kvnen/LVDCDC/LV_DCDC.kicad_pcb

## KiCad design LV_DCDC.kicad_pcb (2026-04-30)

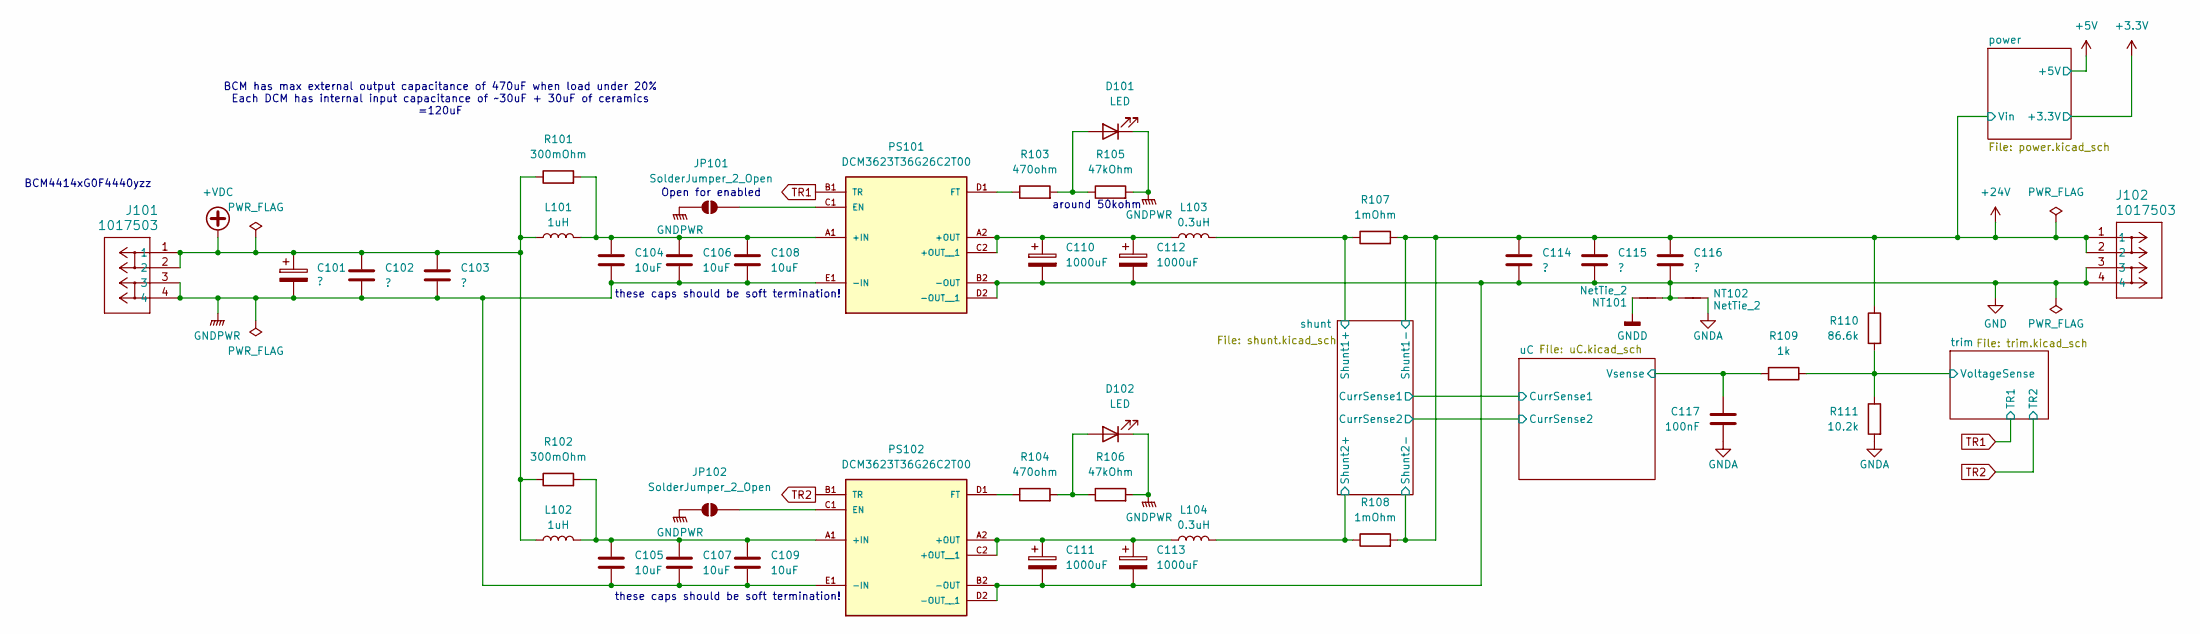
[picture p1: schematic LV_DCDC.kicad_sch]

Parts:
C101: ?; CP_Radial_D12.5mm_P5.00mm
C102, C103, C114, C115, C116: ?; C_1206_3216Metric
C104, C105, C106, C107, C108, C109: 10uF; C_1206_3216Metric
C110, C111, C112, C113: 1000uF; CP_Radial_D12.5mm_P5.00mm
C117: 100nF; C_0603_1608Metric
D101, D102: LED; LED_0603_1608Metric
J101, J102: 1017503; CONN_1017491
JP101, JP102: SolderJumper_2_Open; SolderJumper-2_P1.3mm_Open_TrianglePad1.0x1.5mm
L101, L102: 1uH; L_Bourns_SRP1770TA_16.9x16.9mm
L103, L104: 0.3uH; L_APV_APH1040
NT101, NT102: NetTie_2; NetTie-2_SMD_Pad2.0mm
PS101, PS102: DCM3623T36G26C2T00; CONV_DCM3623T36G26C2T00; PARTREV 1.2
R101, R102: 300mOhm; R_1206_3216Metric
R103, R104: 470ohm; R_0603_1608Metric
R105, R106: 47kOhm; R_0603_1608Metric
R107, R108: 1mOhm; R_2512_6332Metric
R109: 1k; R_0603_1608Metric
R110: 86.6k; R_0603_1608Metric
R111: 10.2k; R_0603_1608Metric

Connections:
+24V: C114.1, C115.1, C116.1, J102.1, J102.2, R107.2, R108.2, R110.1; also elsewhere on the board
+VDC: C101.1, C102.1, C103.1, J101.1, J101.2, L101.1, L102.1, R101.1, R102.1
/shunt/Shunt1+: L103.2, R107.1; also elsewhere on the board
/shunt/Shunt2+: L104.2, R108.1; also elsewhere on the board
/trim/VoltageSense: R109.1, R110.2, R111.1; also elsewhere on the board
/uC/Vsense: C117.1, R109.2; also elsewhere on the board
GND: C110.2, C111.2, C112.2, C113.2, C114.2, C115.2, C116.2, J102.3, J102.4, NT101.2, NT102.2, PS101.B2 (-OUT), PS101.D2 (-OUT__1), PS102.B2 (-OUT), PS102.D2 (-OUT__1)
GNDA: C117.2, NT102.1, R111.2; also elsewhere on the board
GNDD: NT101.1; also elsewhere on the board
GNDPWR: C101.2, C102.2, C103.2, C104.2, C105.2, C106.2, C107.2, C108.2, C109.2, D101.1 (K), D102.1 (K), J101.3, J101.4, JP101.2 (B), JP102.2 (B), PS101.E1 (-IN), PS102.E1 (-IN), R105.2, R106.2; also elsewhere on the board
unnamed: D101.2 (A), R103.2, R105.1
unnamed: D102.2 (A), R104.2, R106.1
unnamed: JP101.1 (A), PS101.C1 (EN)
unnamed: JP102.1 (A), PS102.C1 (EN)
unnamed: C104.1, C106.1, C108.1, L101.2, PS101.A1 (+IN), R101.2
unnamed: C110.1, C112.1, L103.1, PS101.A2 (+OUT), PS101.C2 (+OUT__1)
unnamed: PS101.D1 (FT), R103.1
unnamed: C105.1, C107.1, C109.1, L102.2, PS102.A1 (+IN), R102.2
unnamed: C111.1, C113.1, L104.1, PS102.A2 (+OUT), PS102.C2 (+OUT__1)
unnamed: PS102.D1 (FT), R104.1
TR1: PS101.B1 (TR); also elsewhere on the board
TR2: PS102.B1 (TR); also elsewhere on the board

Notes on the sheet:
around 50kohm
Open for enabled
these caps should be soft termination!
BCM has max external output capacitance of 470uF when load under 20% Each DCM has internal input capacitance of ~30uF + 30uF of ceramics =120uF
BCM4414xG0F4440yzz

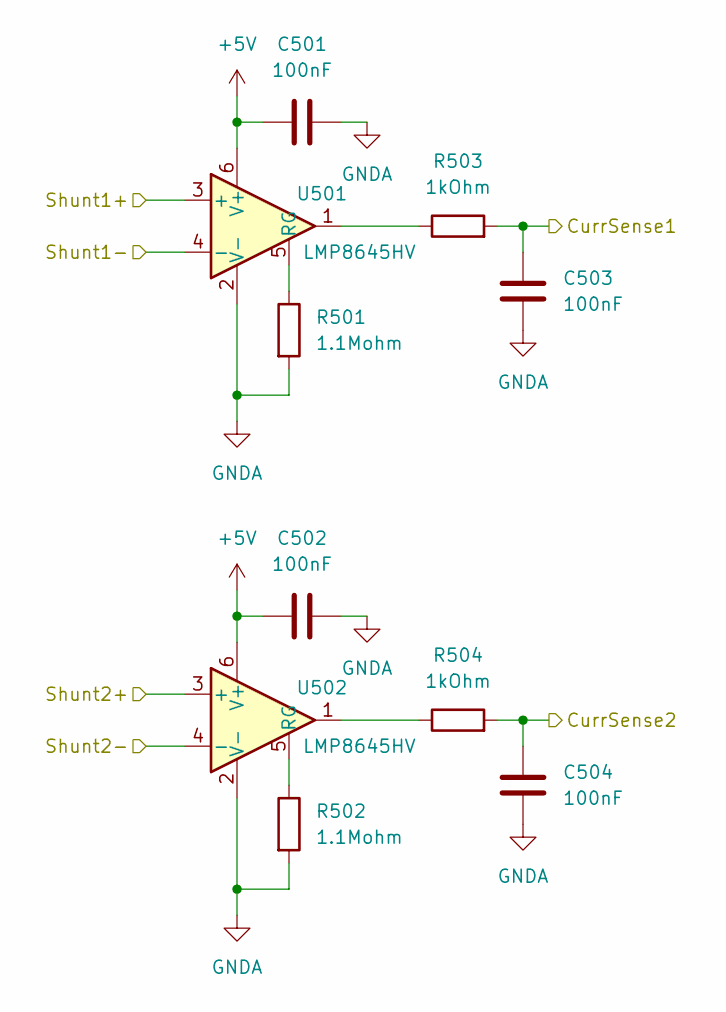
[picture p2: schematic shunt.kicad_sch]

Parts:
C501, C502, C503, C504: 100nF; C_0603_1608Metric
R501, R502: 1.1Mohm; R_0603_1608Metric
R503, R504: 1kOhm; R_0603_1608Metric
U501, U502: LMP8645HV; TSOT-23-6_HandSoldering

Connections:
+5V: C501.1, C502.1, U501.6 (V+), U502.6 (V+); also elsewhere on the board
+24V: U501.4 (-), U502.4 (-); also elsewhere on the board
/shunt/CurrSense1: C503.1, R503.2; also elsewhere on the board
/shunt/CurrSense2: C504.1, R504.2; also elsewhere on the board
/shunt/Shunt1+: U501.3 (+); also elsewhere on the board
/shunt/Shunt2+: U502.3 (+); also elsewhere on the board
GNDA: C501.2, C502.2, C503.2, C504.2, R501.2, R502.2, U501.2 (V-), U502.2 (V-); also elsewhere on the board
unnamed: R503.1, U501.1
unnamed: R504.1, U502.1
unnamed: R501.1, U501.5 (RG)
unnamed: R502.1, U502.5 (RG)

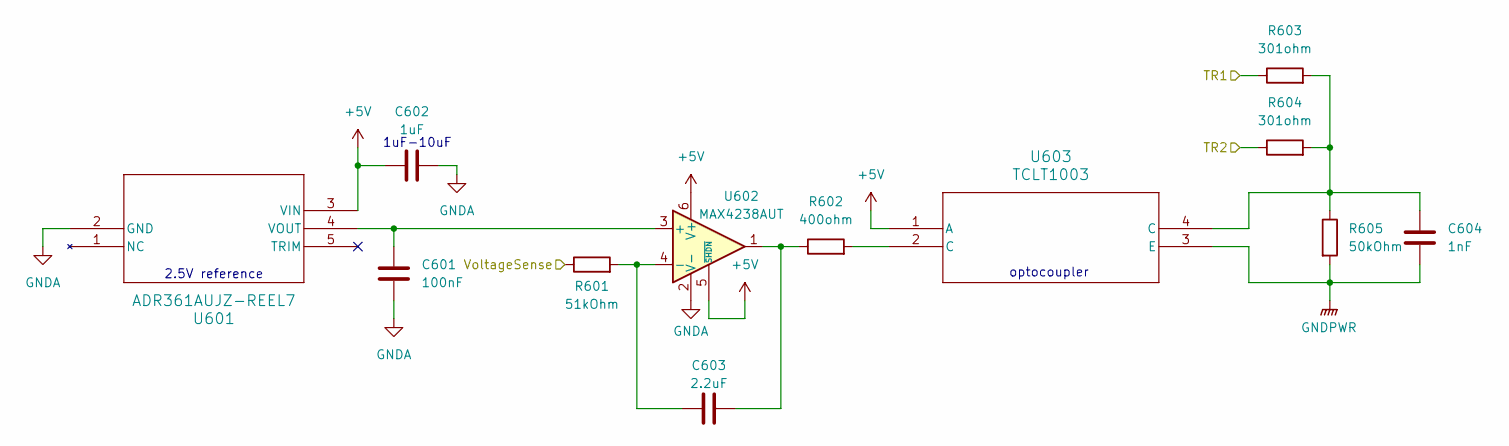
[picture p3: schematic trim.kicad_sch]

Parts:
C601: 100nF; C_0603_1608Metric
C602: 1uF; C_0603_1608Metric
C603: 2.2uF; C_0603_1608Metric
C604: 1nF; C_0603_1608Metric
R601: 51kOhm; R_0603_1608Metric
R602: 400ohm; R_0603_1608Metric
R603, R604: 301ohm; R_0603_1608Metric
R605: 50kOhm; R_0603_1608Metric
U601: ADR361AUJZ-REEL7; UJ_5_ADI
U602: MAX4238AUT; SOT-23-6
U603: TCLT1003; SOP-4L_TC

Connections:
+5V: C602.1, U601.3 (VIN), U602.5 (~SHDN), U602.6 (V+), U603.1 (A); also elsewhere on the board
/trim/VoltageSense: R601.1; also elsewhere on the board
GNDA: C601.2, C602.2, U601.2 (GND), U602.2 (V-); also elsewhere on the board
GNDPWR: C604.2, R605.2, U603.3 (E); also elsewhere on the board
unnamed: C603.2, R602.1, U602.1
unnamed: C604.1, R603.2, R604.2, R605.1, U603.4 (C)
unnamed: R602.2, U603.2 (C)
unnamed: C601.1, U601.4 (VOUT), U602.3 (+)
unnamed: C603.1, R601.2, U602.4 (-)
TR1: R603.1; also elsewhere on the board
TR2: R604.1; also elsewhere on the board

Notes on the sheet:
2.5V reference
optocoupler
1uF-10uF

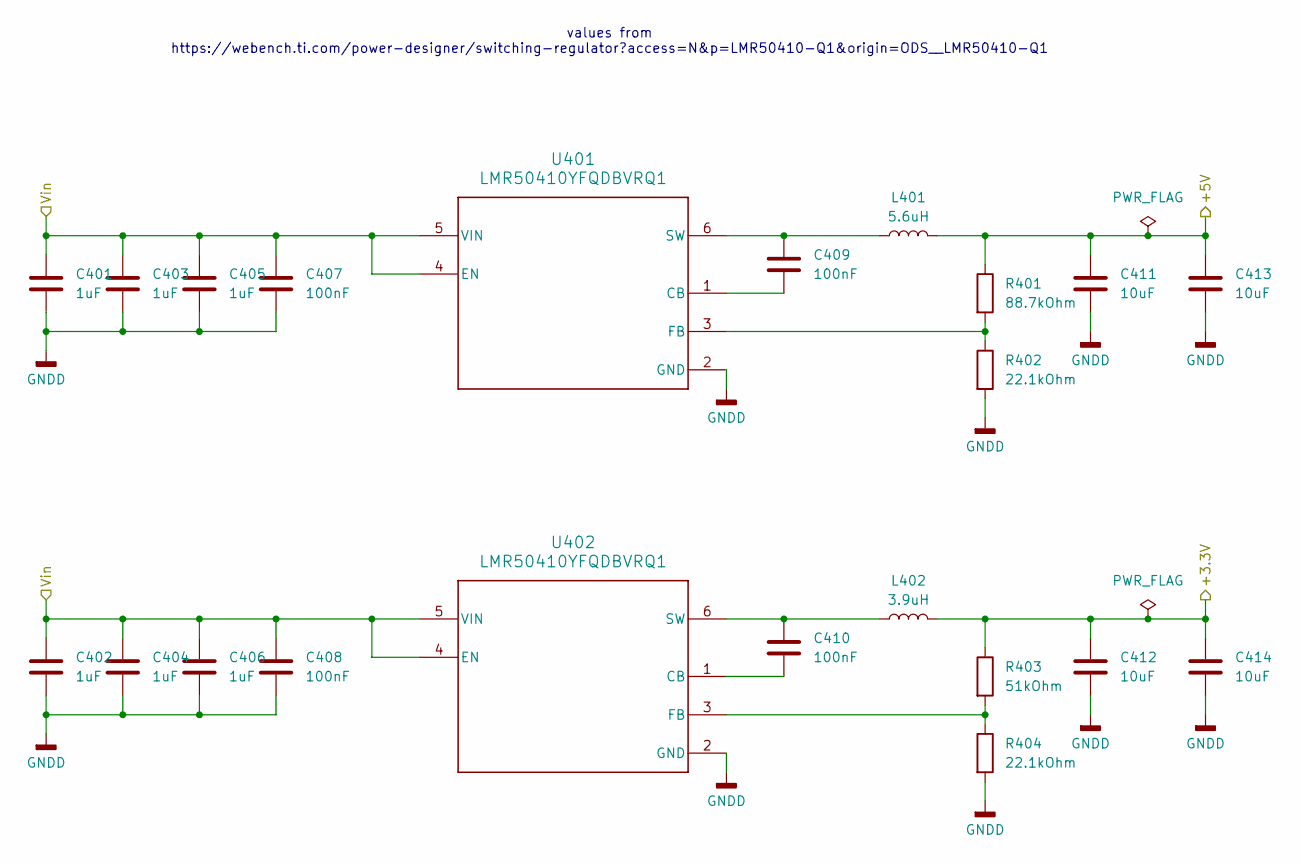
[picture p4: schematic power.kicad_sch]

Parts:
C401, C402, C403, C404, C405, C406: 1uF; C_1206_3216Metric
C407, C408, C409, C410: 100nF; C_0603_1608Metric
C411, C412, C413, C414: 10uF; C_1206_3216Metric
L401: 5.6uH; L_1812_4532Metric
L402: 3.9uH; L_1812_4532Metric
R401: 88.7kOhm; R_0603_1608Metric
R402, R404: 22.1kOhm; R_0603_1608Metric
R403: 51kOhm; R_0603_1608Metric
U401, U402: LMR50410YFQDBVRQ1; DBV0006A-IPC_A

Connections:
+3.3V: C412.1, C414.1, L402.2, R403.1; also elsewhere on the board
+5V: C411.1, C413.1, L401.2, R401.1; also elsewhere on the board
+24V: C401.1, C402.1, C403.1, C404.1, C405.1, C406.1, C407.1, C408.1, U401.4 (EN), U401.5 (VIN), U402.4 (EN), U402.5 (VIN); also elsewhere on the board
GNDD: C401.2, C402.2, C403.2, C404.2, C405.2, C406.2, C407.2, C408.2, C411.2, C412.2, C413.2, C414.2, R402.2, R404.2, U401.2 (GND), U402.2 (GND); also elsewhere on the board
unnamed: C409.2, U401.1 (CB)
unnamed: R401.2, R402.1, U401.3 (FB)
unnamed: C409.1, L401.1, U401.6 (SW)
unnamed: C410.2, U402.1 (CB)
unnamed: R403.2, R404.1, U402.3 (FB)
unnamed: C410.1, L402.1, U402.6 (SW)

Notes on the sheet:
values from https://webench.ti.com/power-designer/switching-regulator?access=N&p=LMR50410-Q1&origin=ODS__LMR50410-Q1

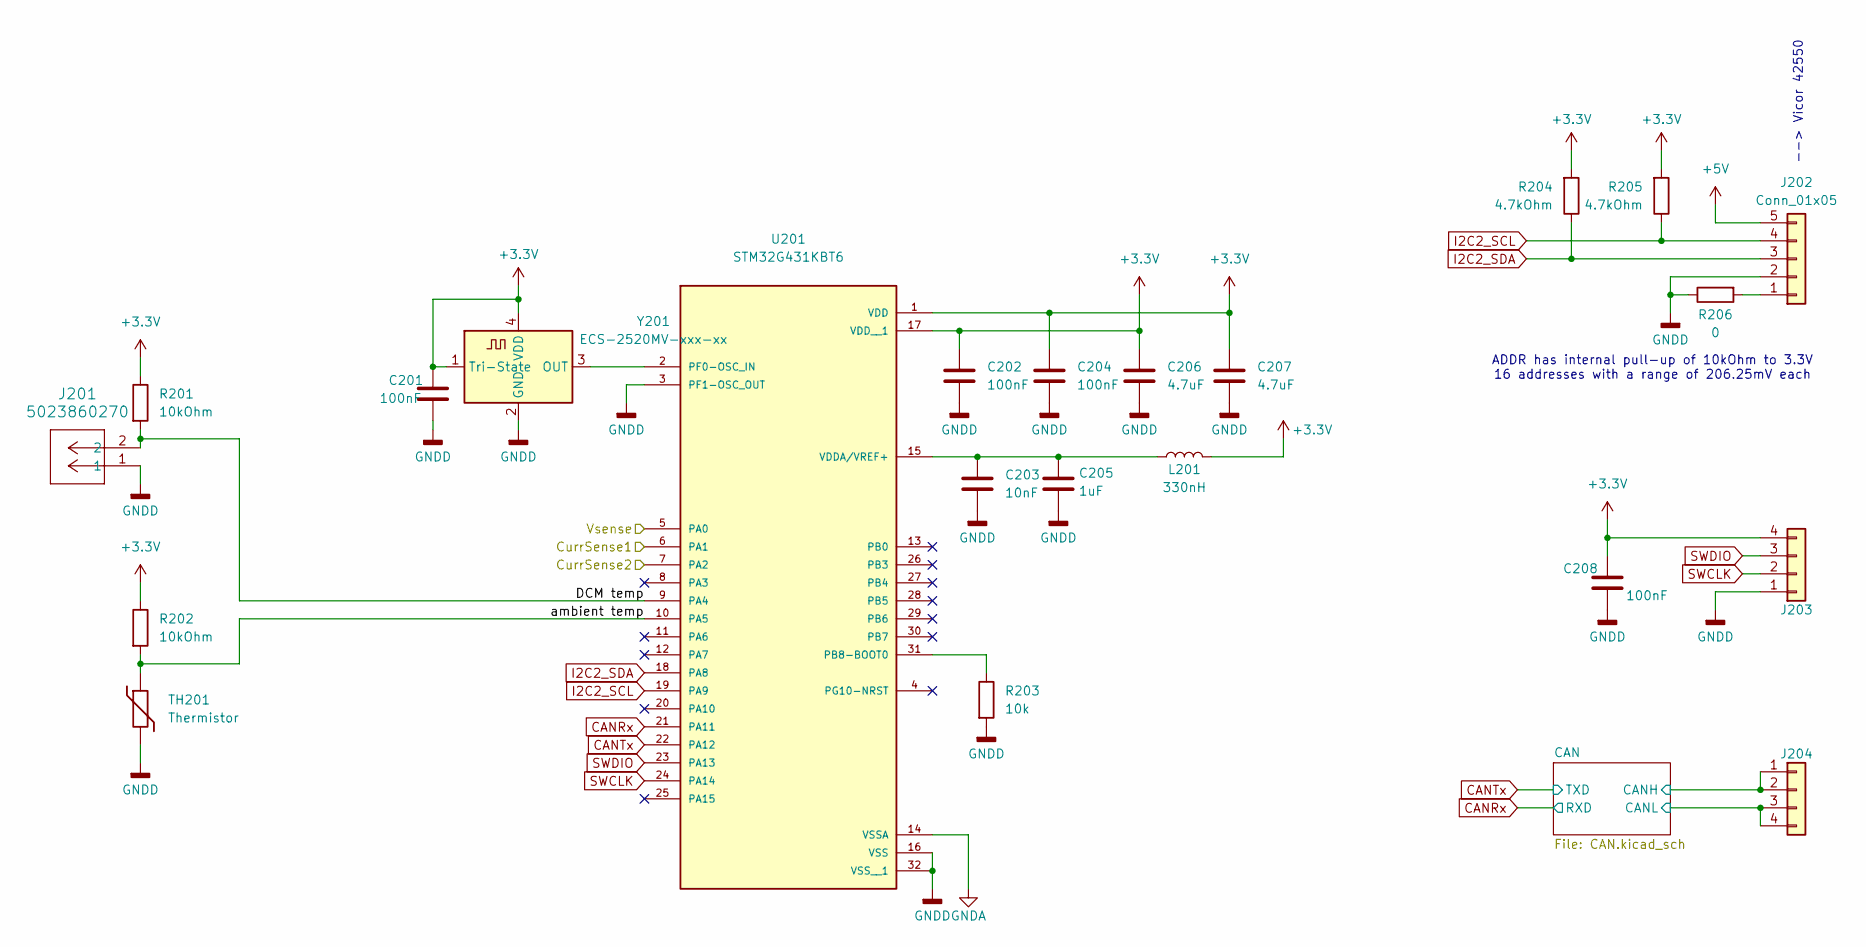
[picture p5: schematic uC.kicad_sch]

Parts:
C201, C202, C204: 100nF; C_0603_1608Metric
C203: 10nF; C_0603_1608Metric
C205: 1uF; C_0603_1608Metric
C206, C207: 4.7uF; C_0603_1608Metric
C208: 100nF; C_0805_2012Metric_Pad1.18x1.45mm_HandSolder; TOLERANCE (FILL IN AS +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 10%
J201: 5023860270; CONN_502386-02xx_MOL
J202: Conn_01x05; PinHeader_2x05_P2.54mm_Vertical
J203: Conn_01x04; PinSocket_1x04_P2.54mm_Vertical
J204: Conn_01x04; PinHeader_2x04_P2.54mm_Vertical
L201: 330nH; L_0805_2012Metric
R201, R202: 10kOhm; R_0603_1608Metric
R203: 10k; R_0603_1608Metric
R204, R205: 4.7kOhm; R_0603_1608Metric
R206: 0; R_0603_1608Metric
TH201: Thermistor; R_0805_2012Metric
U201: STM32G431KBT6; LQFP-32_7x7mm_P0.8mm; PARTREV 2
Y201: ECS-2520MV-xxx-xx; Oscillator_SMD_ECS_2520MV-xxx-xx-4Pin_2.5x2.0mm

Connections:
+3.3V: C201.1, C202.1, C204.1, C206.1, C207.1, C208.1, J203.4, L201.2, R201.1, R202.1, R204.2, R205.2, U201.1 (VDD), U201.17 (VDD__1), Y201.1 (Tri-State), Y201.4 (VDD); also elsewhere on the board
+5V: J202.5; also elsewhere on the board
/shunt/CurrSense1: U201.6 (PA1); also elsewhere on the board
/shunt/CurrSense2: U201.7 (PA2); also elsewhere on the board
/uC/CAN/CANH: J204.1, J204.2; also elsewhere on the board
/uC/CAN/CANL: J204.3, J204.4; also elsewhere on the board
/uC/DCM temp: J201.2, R201.2, U201.9 (PA4)
/uC/Vsense: U201.5 (PA0); also elsewhere on the board
/uC/ambient temp: R202.2, TH201.1, U201.10 (PA5)
CANRx: U201.21 (PA11); also elsewhere on the board
CANTx: U201.22 (PA12); also elsewhere on the board
GNDA: U201.14 (VSSA); also elsewhere on the board
GNDD: C201.2, C202.2, C203.2, C204.2, C205.2, C206.2, C207.2, C208.2, J201.1, J202.2, J203.1, R203.2, R206.1, TH201.2, U201.3 (PF1-OSC_OUT), U201.16 (VSS), U201.32 (VSS__1), Y201.2 (GND); also elsewhere on the board
I2C2_SCL: J202.4, R205.1, U201.19 (PA9)
I2C2_SDA: J202.3, R204.1, U201.18 (PA8)
unnamed: J202.1, R206.2
unnamed: R203.1, U201.31 (PB8-BOOT0)
unnamed: U201.2 (PF0-OSC_IN), Y201.3 (OUT)
unnamed: C203.1, C205.1, L201.1, U201.15 (VDDA/VREF+)
SWCLK: J203.2, U201.24 (PA14)
SWDIO: J203.3, U201.23 (PA13)

Notes on the sheet:
--> Vicor 42550
ADDR has internal pull-up of 10kOhm to 3.3V 16 addresses with a range of 206.25mV each

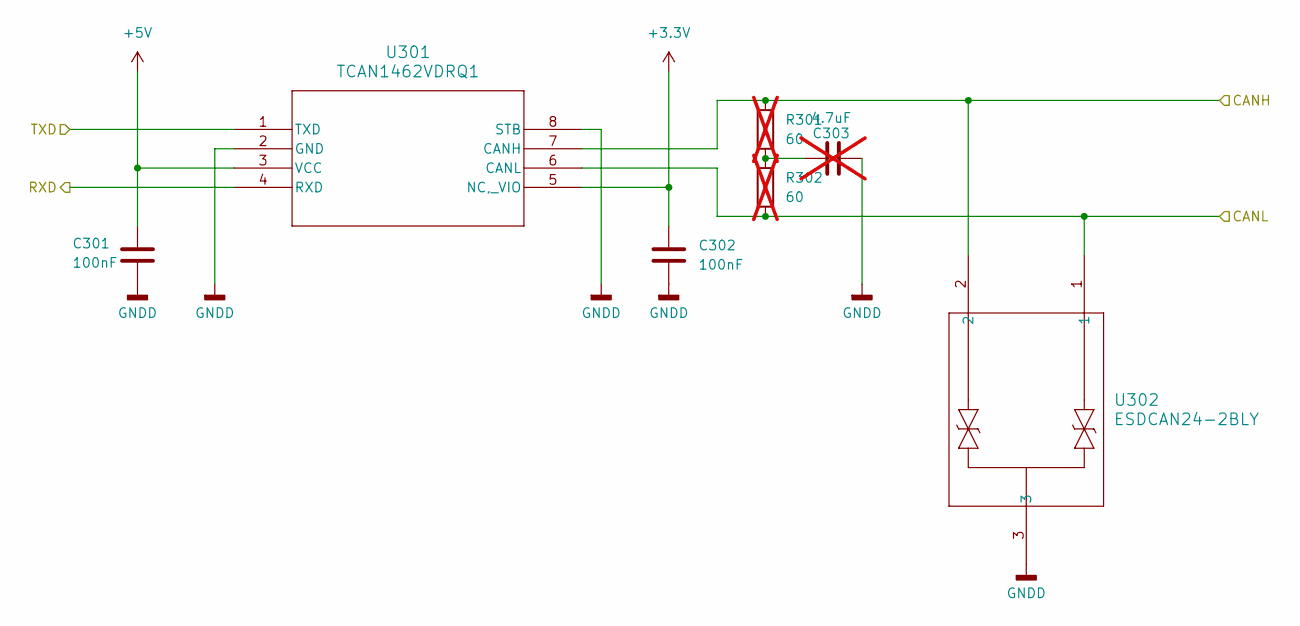
[picture p6: schematic CAN.kicad_sch]

Parts:
C301, C302: 100nF; C_0603_1608Metric
C303: 4.7uF; C_0603_1608Metric; not fitted
R301, R302: 60; R_0603_1608Metric; not fitted
U301: TCAN1462VDRQ1; SOIC8_D_TEX
U302: ESDCAN24-2BLY; SOT_24-2BLY_STM

Connections:
+3.3V: C302.1, U301.5 (NC,_VIO); also elsewhere on the board
+5V: C301.1, U301.3 (VCC); also elsewhere on the board
/uC/CAN/CANH: R301.1, U301.7 (CANH), U302.2; also elsewhere on the board
/uC/CAN/CANL: R302.2, U301.6 (CANL), U302.1; also elsewhere on the board
CANRx: U301.4 (RXD); also elsewhere on the board
CANTx: U301.1 (TXD); also elsewhere on the board
GNDD: C301.2, C302.2, C303.1, U301.2 (GND), U301.8 (STB), U302.3; also elsewhere on the board
unnamed: C303.2, R301.2, R302.1

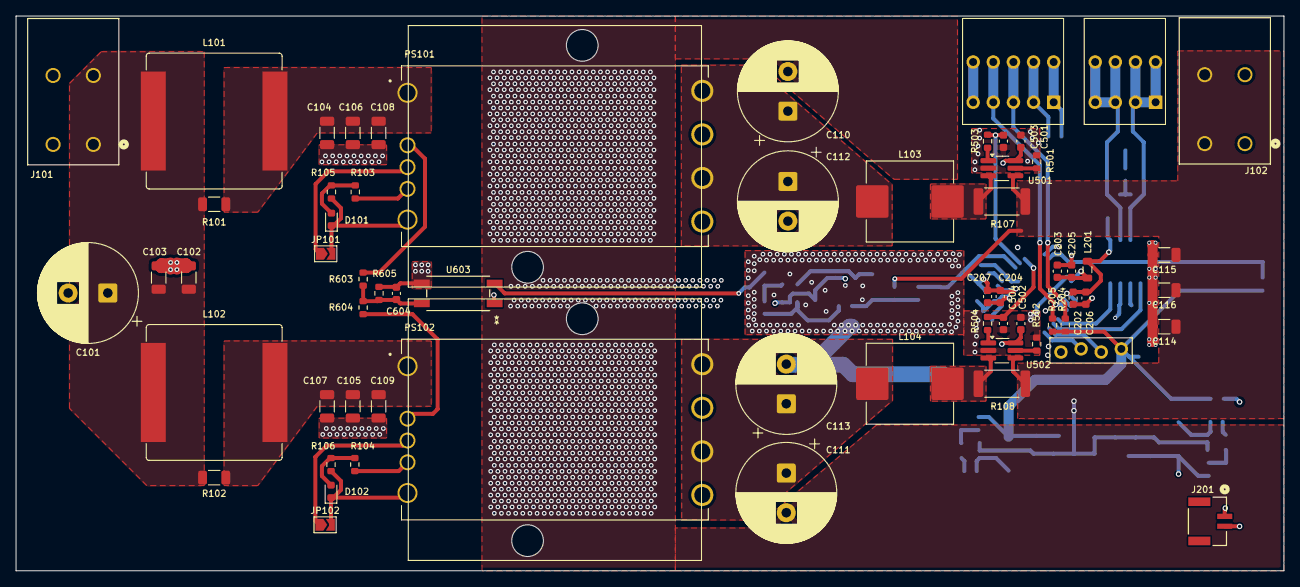
[picture p7: board LV_DCDC.kicad_pcb from above]

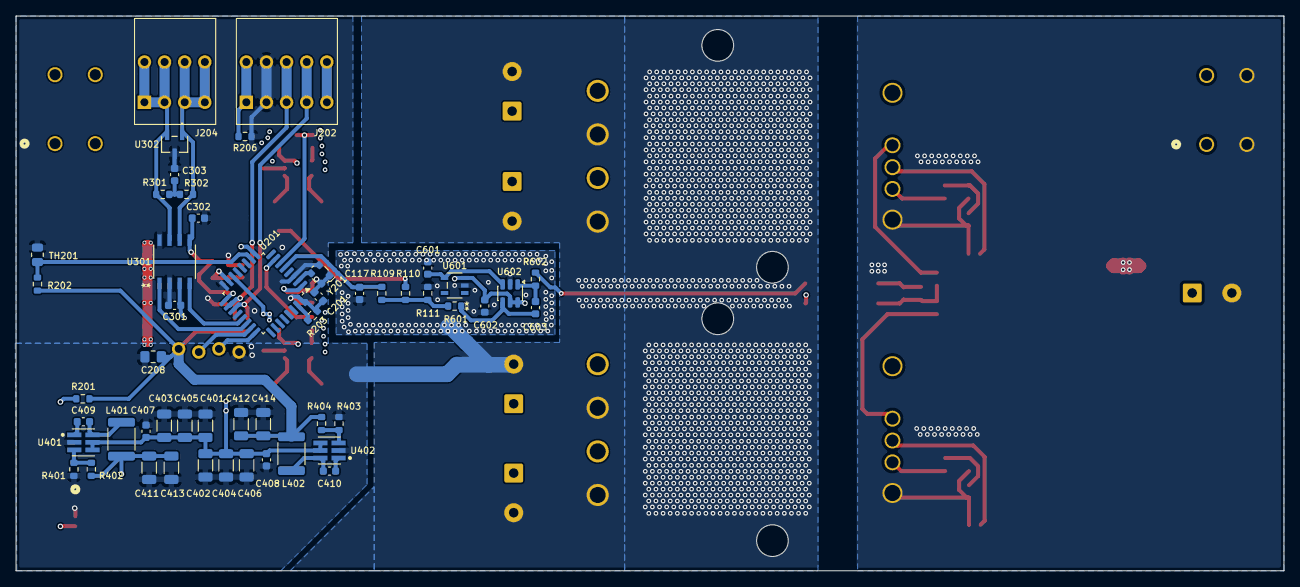
[picture p8: board LV_DCDC.kicad_pcb from below]

Board: 4 copper layers, 160.0 x 70.0 mm, 115 parts (53 on the bottom side), 56 nets.
