kvnen/LVDCDC/(commit log)

2026-03-24 uC schema added
    [uC.kicad_sch]
2026-03-24 added xtal
    [uC.kicad_sch]
2026-03-29 found the correct i2c logic level shifter.
    [uC.kicad_sch]
2026-03-29 made todo, added power
    [LV_DCDC.kicad_sch, power.kicad_sch, uC.kicad_sch]
2026-03-30 fixed bcm connector, added thermistors something else too prolly
    [CAN.kicad_sch, LV_DCDC.kicad_sch, shunt.kicad_sch, uC.kicad_sch]
2026-03-30 moved to kicad 10
    [CAN.kicad_sch, LV_DCDC.kicad_sch, power.kicad_sch, shunt.kicad_sch, uC.kicad_sch]
2026-03-31 did some stuff yesterday i dont remember
    [CAN.kicad_sch, LV_DCDC.kicad_pcb, LV_DCDC.kicad_sch, power.kicad_sch, trim.kicad_sch, uC.kicad_sch]
2026-04-19 started on shunt
    [shunt.kicad_sch]
2026-04-20 Made trim circuit
    [LV_DCDC.kicad_sch, shunt.kicad_sch, trim.kicad_sch, uC.kicad_sch]
2026-04-21 added shunts
    [LV_DCDC.kicad_sch, shunt.kicad_sch, uC.kicad_sch]
2026-04-21 assigned footprints, some minor schematic stuff, started layout
    [CAN.kicad_sch, LV_DCDC.kicad_pcb, LV_DCDC.kicad_sch, power.kicad_sch, shunt.kicad_sch, trim.kicad_sch, uC.kicad_sch]
2026-04-22 progress on layout in general, minor tweaks to schemas
    [CAN.kicad_sch, LV_DCDC.kicad_pcb, uC.kicad_sch]
2026-04-22 made heatsink holes
    [LV_DCDC.kicad_pcb, uC.kicad_sch]
2026-04-25 Layout done except for silkscreen
    [LV_DCDC.kicad_pcb, LV_DCDC.kicad_sch, power.kicad_sch, uC.kicad_sch]
2026-04-26 moved the accuracy trim to bottom side. added stitching to bottom of DCMs
    [LV_DCDC.kicad_pcb]
2026-04-28 fixed ref. des. on silk screen
    [LV_DCDC.kicad_pcb]
2026-04-30 added heatsink mounting holes
2026-04-30 heat sink mount holes
    [LV_DCDC.kicad_pcb]
